ivanarasch/Ivanita-s-DIY-DJ-Controller/(commit log)

2025-12-20 Create Arduino
2025-12-20 Add complete MIDI controller code for Teensy 4.1
2025-12-20 Swap PCB images and update captions in README
